orviwan/bigdub/cad/official_pebble_models/pebble_classic_drawing-1.png

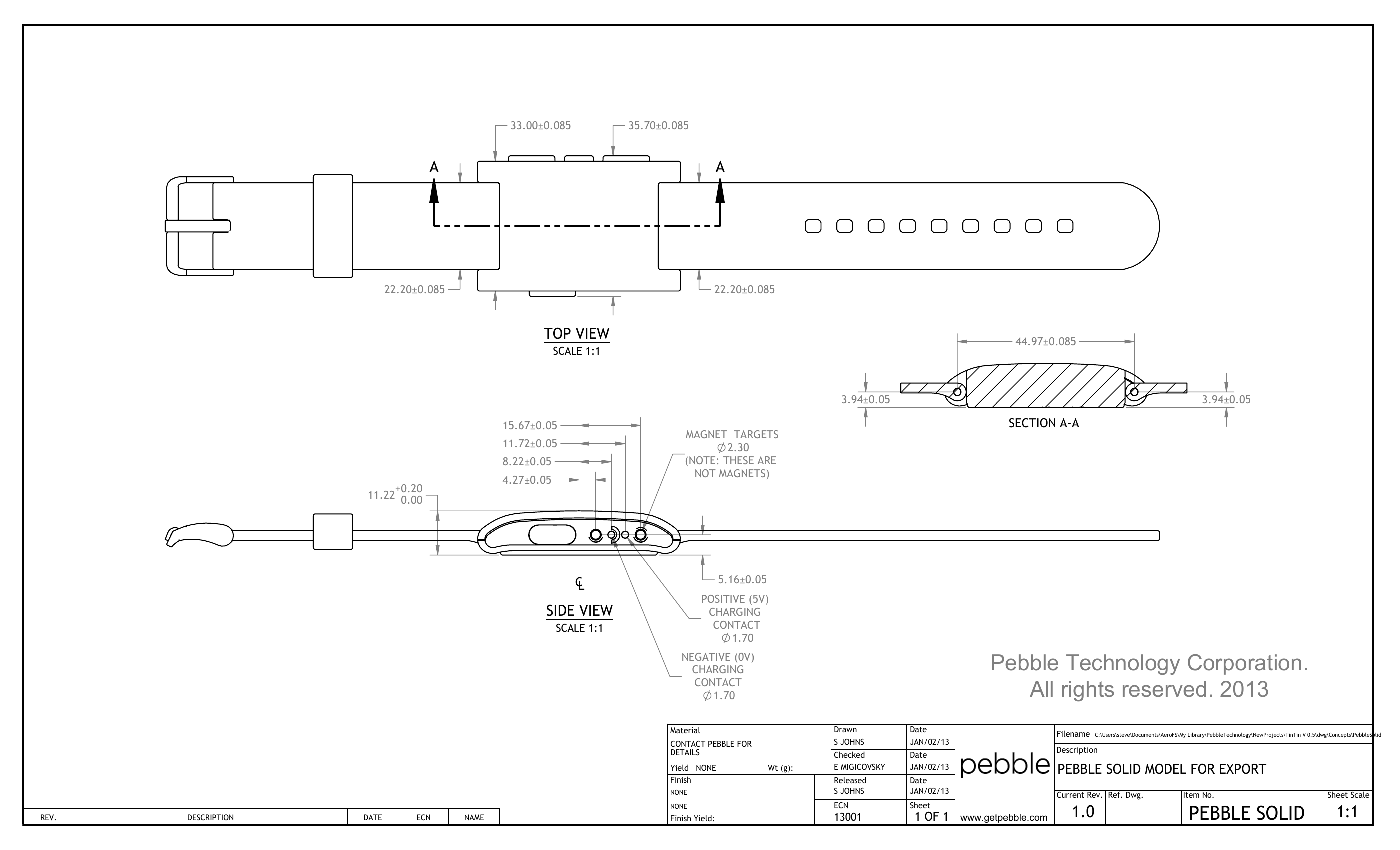
cad/official_pebble_models/pebble_classic_drawing-1.png
