orviwan/bigdub/cad/pebble_screen_texture.png

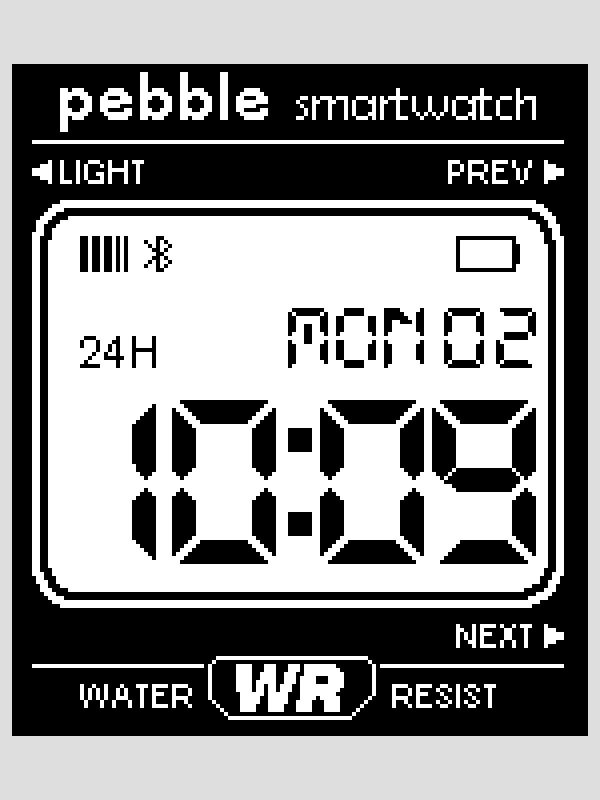
cad/pebble_screen_texture.png
