orviwan/bigdub/cad/textures/91dub_nook_screen.png

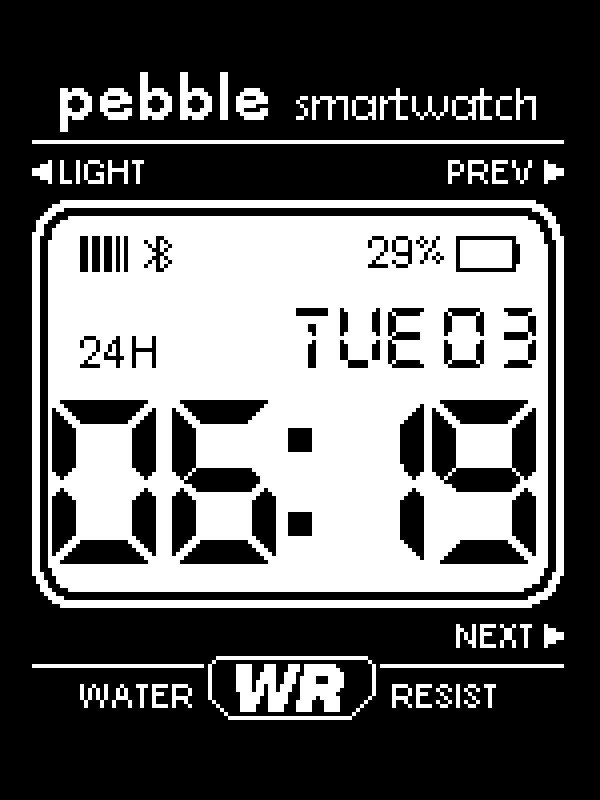
cad/textures/91dub_nook_screen.png
