orviwan/bigdub/cad/stls/pebble_clock_full_assembly.stl

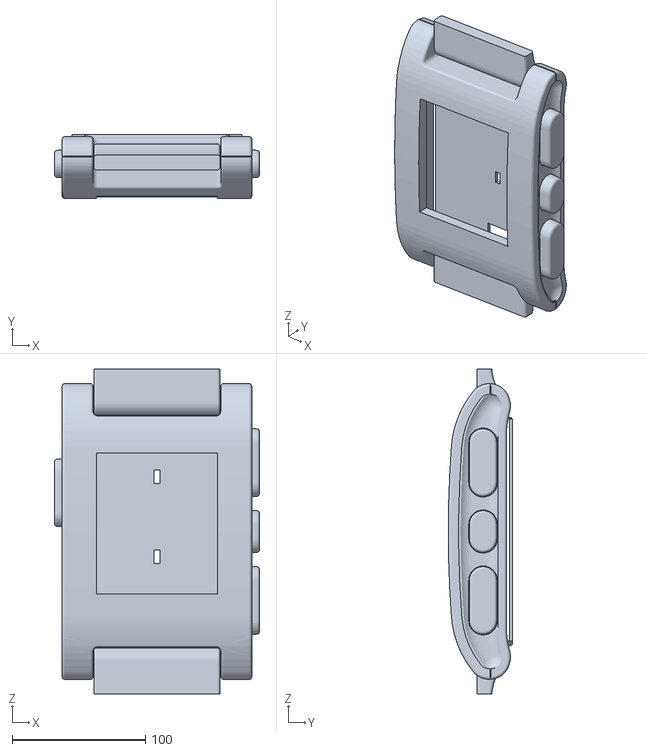
[picture p6: CAD file, 2026-11-07]
cad/stls/pebble_clock_full_assembly.stl
154.0 x 48.4 x 244.0
