orviwan/bigdub/cad/stls/pebble_classic_clock_full_assembly.stl

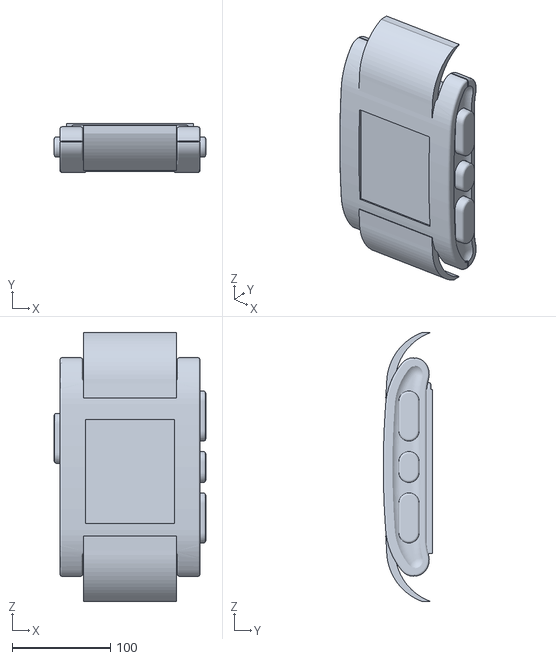
[picture p7: CAD file, 2026-11-07]
cad/stls/pebble_classic_clock_full_assembly.stl
154.0 x 50.2 x 273.4
