orviwan/bigdub/cad/official_pebble_models/pebble_2_3d.stl

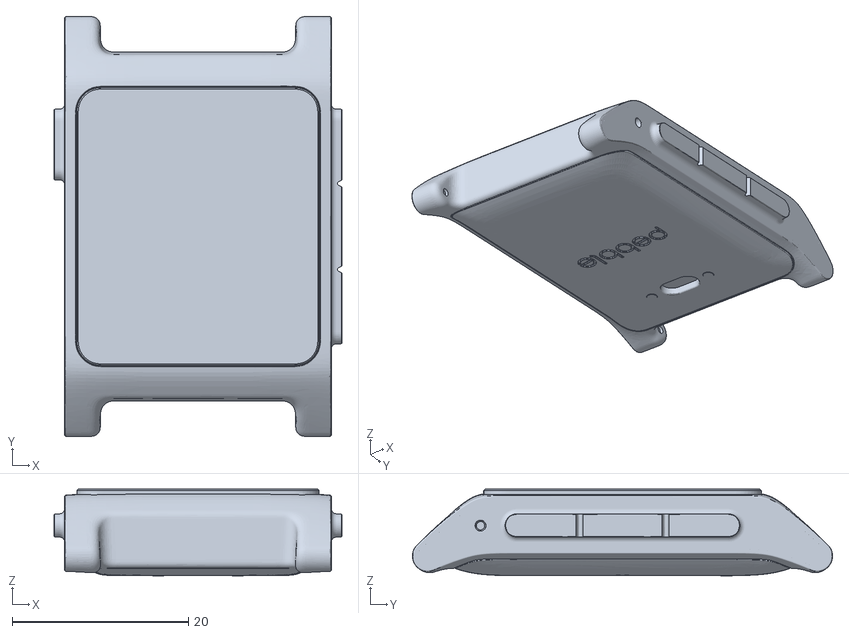
[picture p8: CAD file, 2026-11-07]
cad/official_pebble_models/pebble_2_3d.stl
32.7 x 47.6 x 9.85
