orviwan/bigdub/cad/stls/pebble_classic_strap_bottom.stl

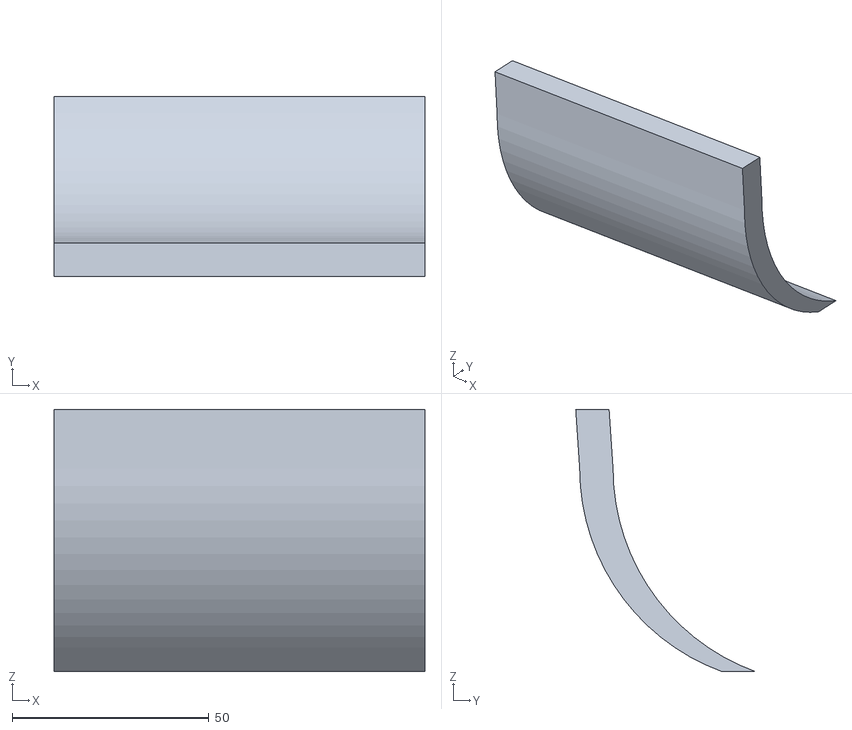
[picture p9: CAD file, 2026-11-07]
cad/stls/pebble_classic_strap_bottom.stl
94.4 x 45.7 x 66.7
