orviwan/bigdub/cad/official_pebble_models/pebble_time_steel.stl

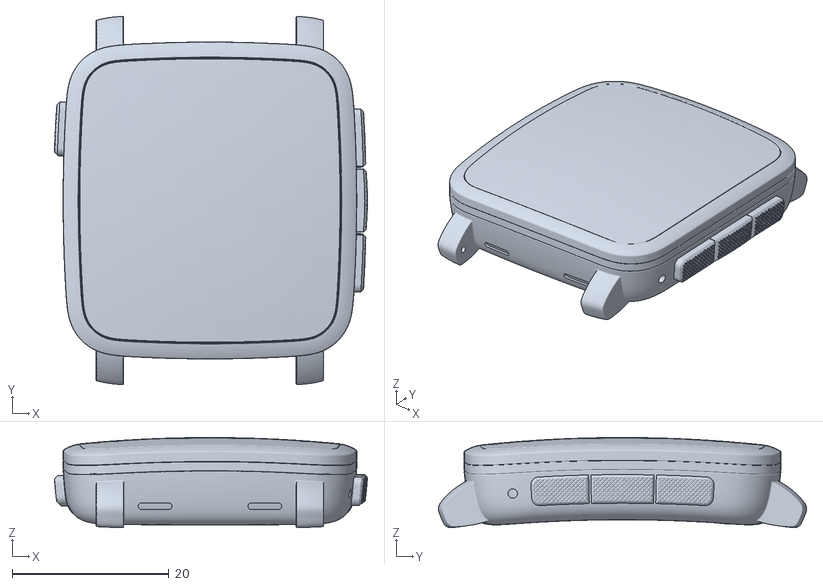
[picture p10: CAD file, 2026-11-07]
cad/official_pebble_models/pebble_time_steel.stl
39.9 x 46.9 x 11.5
