orviwan/bigdub/cad/official_pebble_models/pebble_2_duo_solid.stl

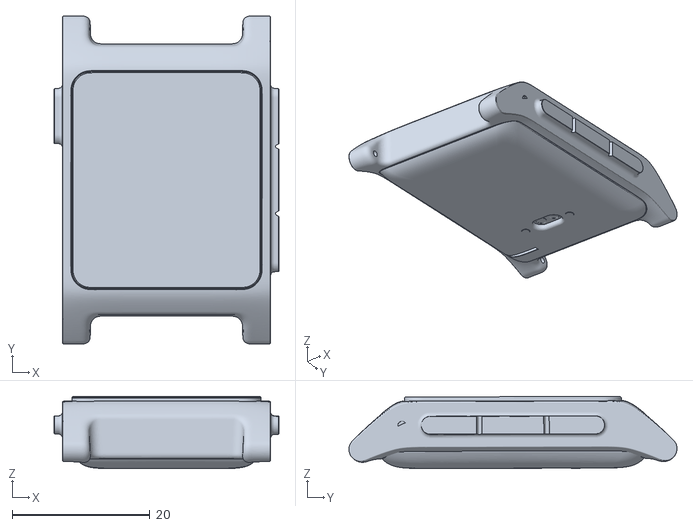
[picture p11: CAD file, 2026-11-07]
cad/official_pebble_models/pebble_2_duo_solid.stl
32.6 x 47.6 x 10.5
