orviwan/bigdub/cad/stls/pebble_clock_back_cover.stl

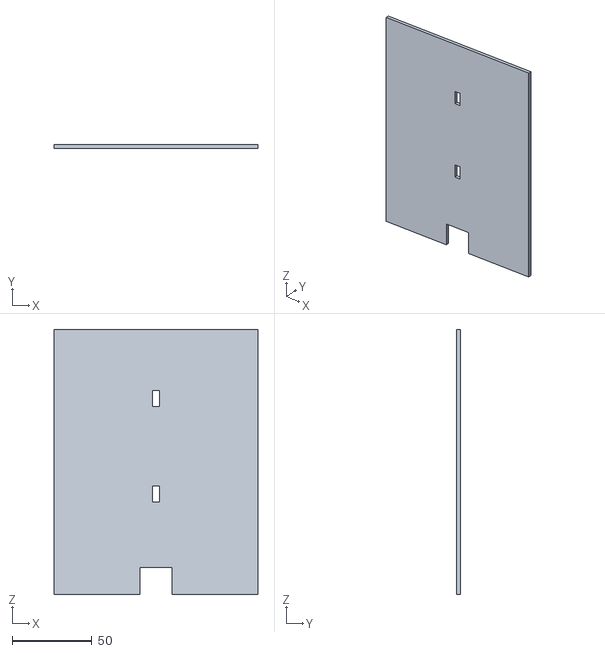
[picture p12: CAD file, 2026-11-07]
cad/stls/pebble_clock_back_cover.stl
128.0 x 2.50 x 166.5
