orviwan/bigdub/cad/official_pebble_models/pebble_time_exterior.stl

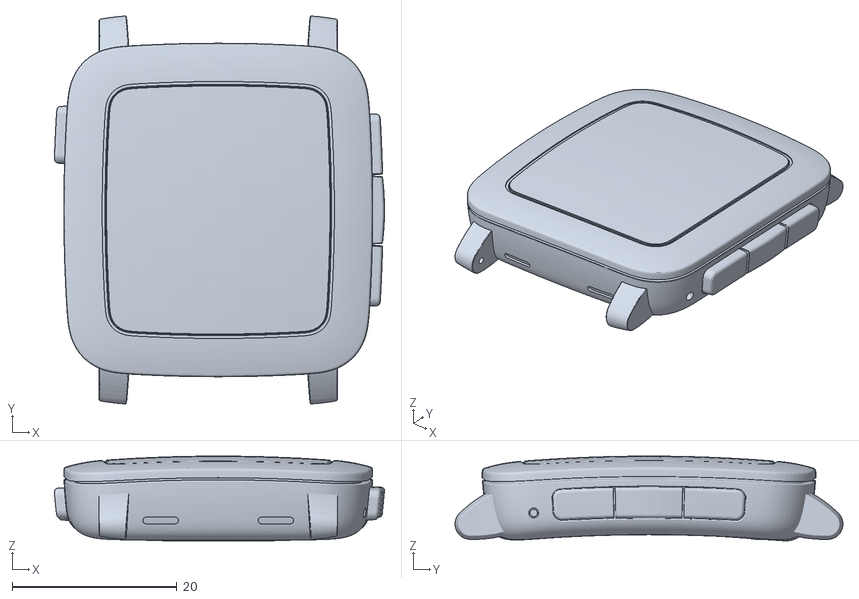
[picture p13: CAD file, 2026-11-07]
cad/official_pebble_models/pebble_time_exterior.stl
40.1 x 47.1 x 10.3
