orviwan/bigdub/cad/stls/pebble_classic_clock_body.stl

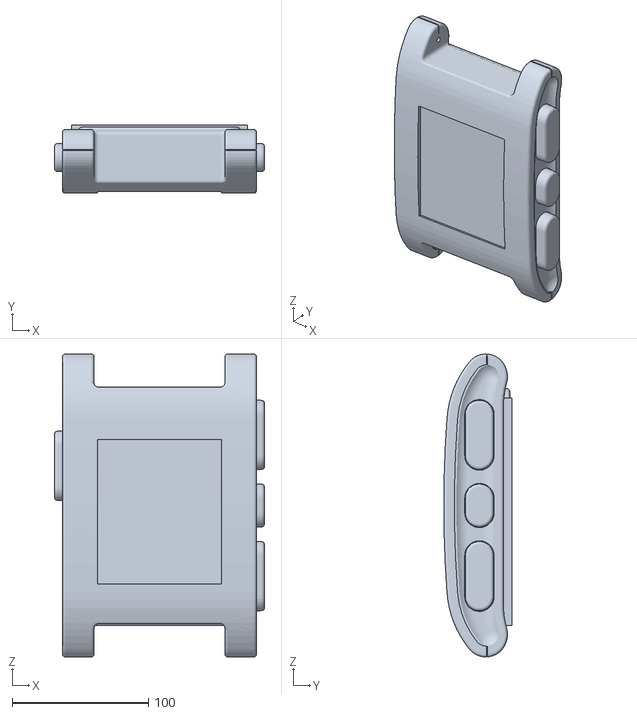
[picture p14: CAD file, 2026-11-07]
cad/stls/pebble_classic_clock_body.stl
154.0 x 50.2 x 222.1
