orviwan/bigdub/cad/official_pebble_models/PebbleSolid-20130102.STEP

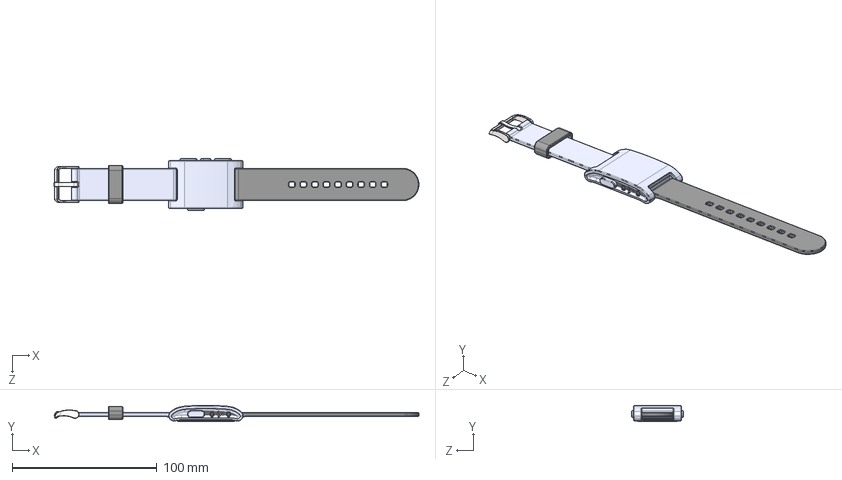
[picture p15: CAD file, 2026-11-07]
cad/official_pebble_models/PebbleSolid-20130102.STEP
252.6 x 11.2 x 35.7 mm
