orviwan/bigdub/cad/stls/pebble_classic_body_1x.stl

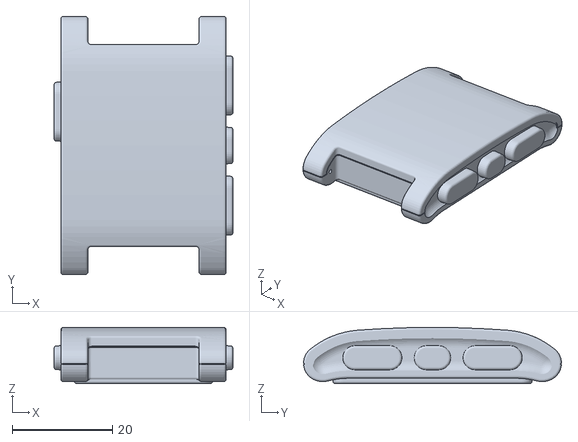
[picture p16: CAD file, 2026-11-07]
cad/stls/pebble_classic_body_1x.stl
35.7 x 51.5 x 11.2
