orviwan/bigdub/cad/stls/pebble_clock_body_PRINT_READY.3mf

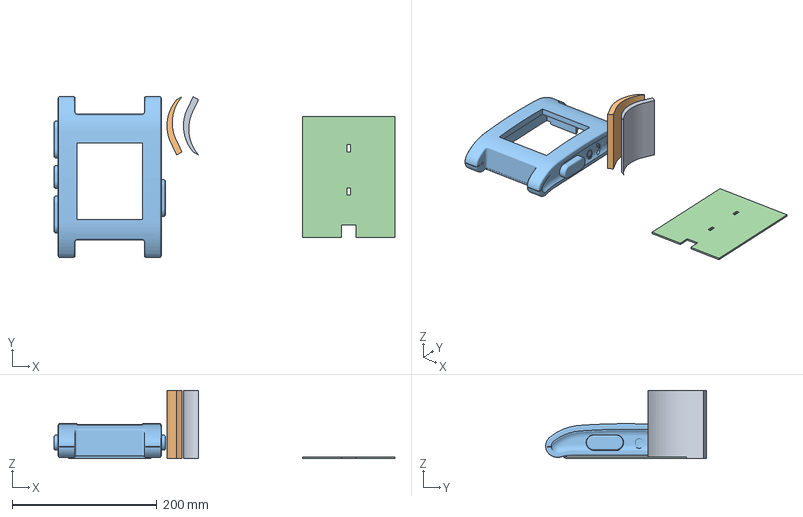
[picture p17: CAD file, 2026-11-07]
cad/stls/pebble_clock_body_PRINT_READY.3mf
471.0 x 222.1 x 94.4 mm
pebble_classic_strap_bottom.stl
pebble_classic_strap_top.stl
pebble_clock_body_PRINT_READY.stl
pebble_clock_back_cover_PRINT_READY.stl
