orviwan/bigdub/cad/stls/pebble_clock_strap_bottom.stl

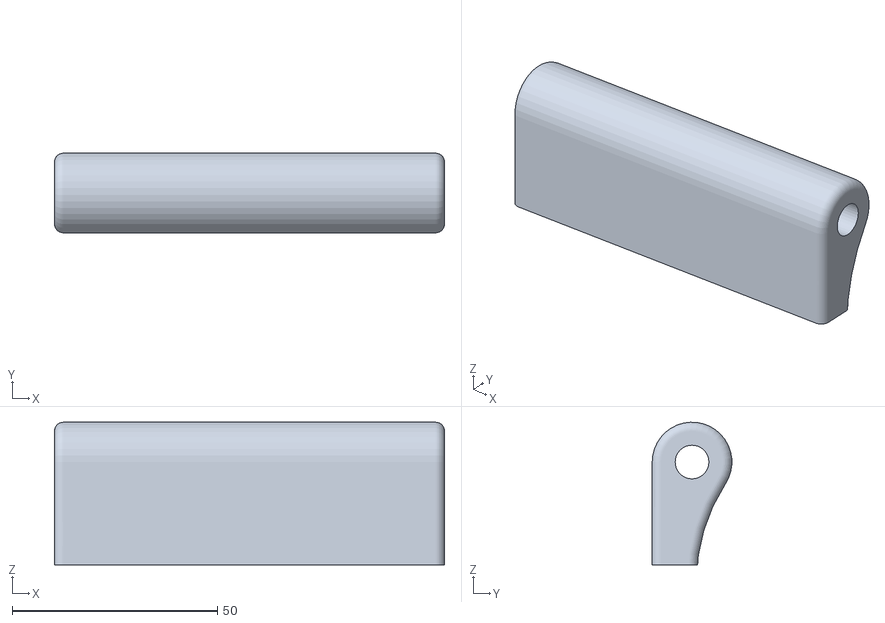
[picture p18: CAD file, 2026-11-07]
cad/stls/pebble_clock_strap_bottom.stl
94.9 x 19.4 x 34.7
