orviwan/bigdub/cad/stls/pebble_clock_body.stl

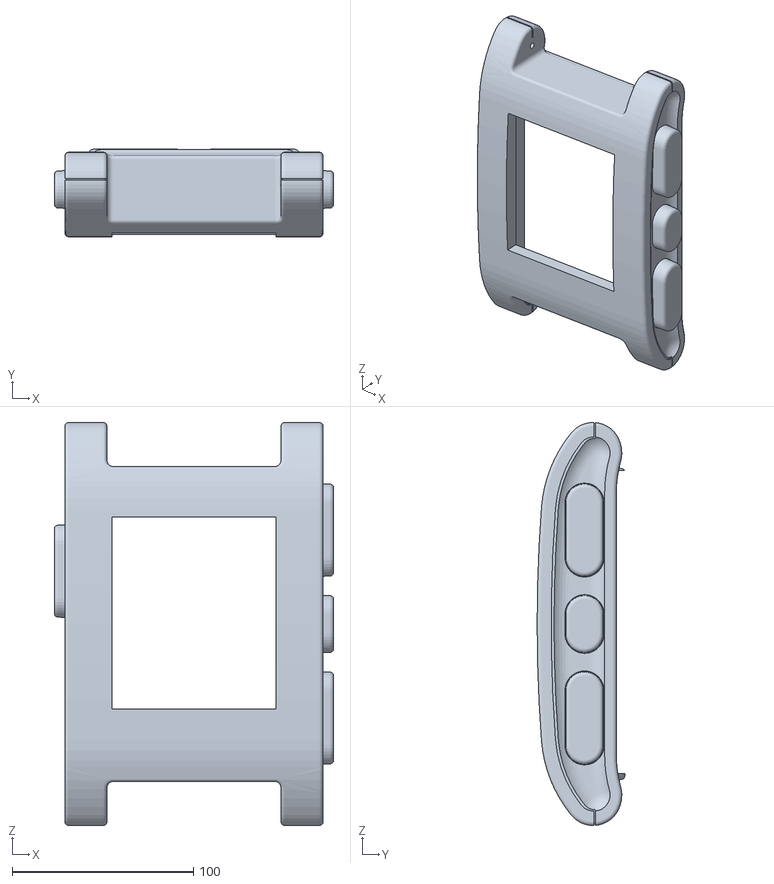
[picture p19: CAD file, 2026-11-07]
cad/stls/pebble_clock_body.stl
154.0 x 48.4 x 222.1
