orviwan/bigdub/cad/stls/giant_pebble_classic_wall_clock.stl

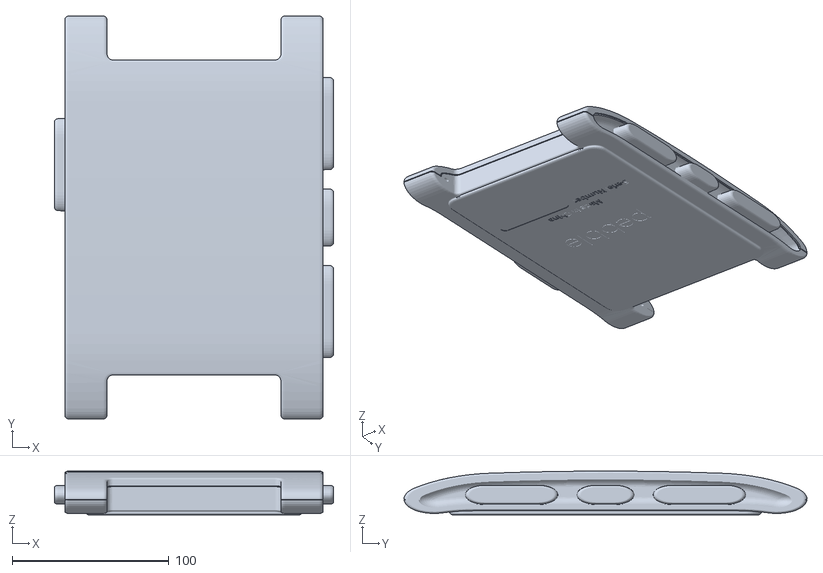
[picture p20: CAD file, 2026-11-07]
cad/stls/giant_pebble_classic_wall_clock.stl
178.5 x 257.4 x 28.0
