orviwan/bigdub/cad/stls/pebble_clock_rear_mount.stl

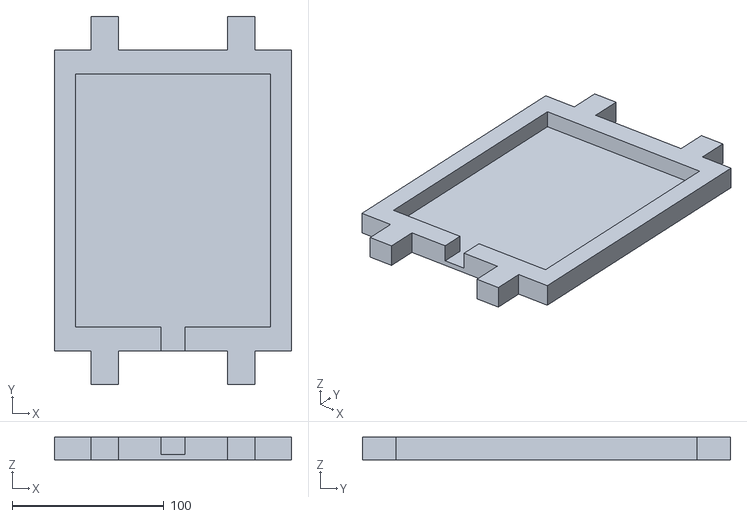
[picture p21: CAD file, 2026-11-02]
cad/stls/pebble_clock_rear_mount.stl
156.2 x 242.2 x 15.0
