orviwan/bigdub/cad/stls/pebble_clock_button_caps.stl

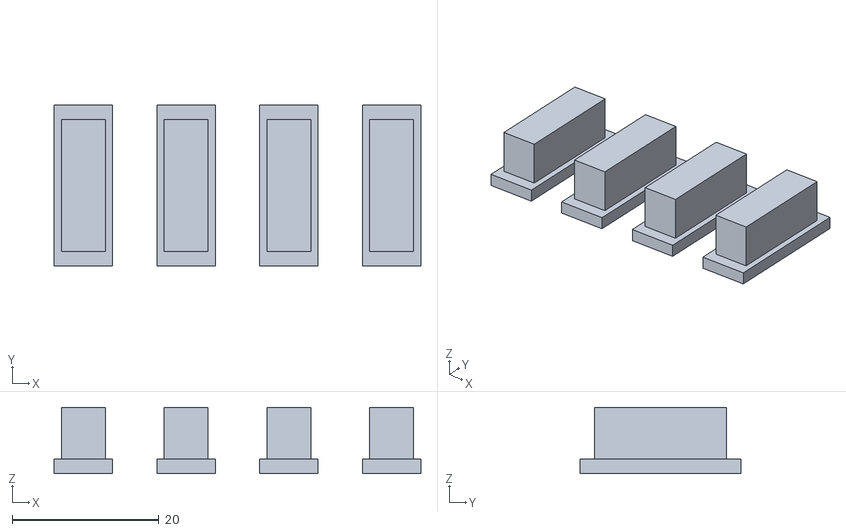
[picture p22: CAD file, 2026-11-02]
cad/stls/pebble_clock_button_caps.stl
50.0 x 22.0 x 9.00
