orviwan/bigdub/cad/stls/pebble_clock_front_bezel.stl

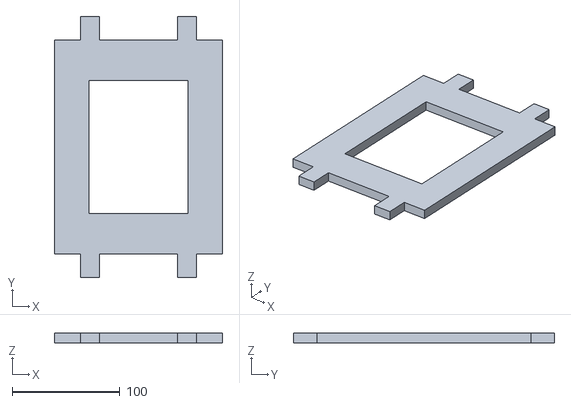
[picture p23: CAD file, 2026-11-02]
cad/stls/pebble_clock_front_bezel.stl
156.2 x 242.2 x 9.00
