orviwan/bigdub/cad/stls/pebble_clock_desk_stand.stl

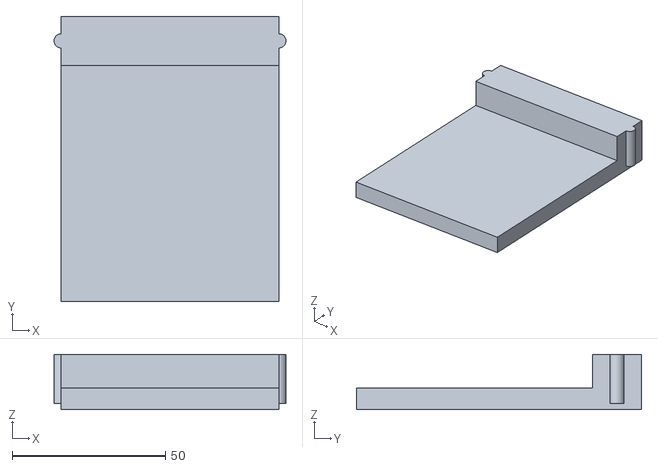
[picture p24: CAD file, 2026-11-02]
cad/stls/pebble_clock_desk_stand.stl
75.6 x 93.0 x 18.0
