orviwan/bigdub/(list of files, cad)

Other CAD files:
cad/stls/pebble_classic_strap_top.stl
cad/stls/pebble_clock_strap_top.stl
cad/stls/pebble_clock_back_cover_PRINT_READY.stl
cad/giant_pebble_wall_clock.blend
cad/official_pebble_models.blend
cad/official_pebble_models/PebbleSolid-20130102.IGS
cad/official_pebble_models/PebbleSolid-20130102.STL
cad/pebble_classic_wall_clock.blend
cad/pebble_wall_clock.blend
cad/stls/pebble_clock_body_PRINT_READY.stl
