orviwan/bigdub/(commit log)

2026-11-02 Initial commit: Pebble 91Dub giant wall clock CAD, E-Ink dashboard, and Nook setup
    [pebble_clock_button_caps.stl, pebble_clock_desk_stand.stl, pebble_clock_front_bezel.stl, pebble_clock_rear_mount.stl, pebble_wall_clock.scad]
2026-11-07 Add production Pebble wall clock CAD, 3D printing guide, watchface conversion docs, and dual licensing
    [PebbleSolid-20130102.IGS, PebbleSolid-20130102.STEP, PebbleSolid-20130102.STL, giant_pebble_classic_wall_clock.stl, giant_pebble_wall_clock.blend, official_pebble_models.blend, pebble_2_3d.stl, pebble_2_duo_solid.stl]
2026-11-07 feat(clock): set default battery to 90% and add query parameter support
2026-11-07 feat(clock): implement day countdown battery mode, fix battery bar z-index, update ADB docs and add AGENTS.md
2026-11-07 cad: tune screen aperture to 90.2x121.8mm to mask E-Ink glass margin; document border physics in AGENTS.md
    [pebble_wall_clock.scad]
2026-11-07 docs: replace CAD render with photo of assembled 3D-printed clock alongside original Pebble
2026-11-07 licensing: clarify MIT license for repo root and CC BY-NC-SA 4.0 for cad/
2026-11-09 feat(clock): regenerate 4x DS-Digital-Bold sprites, fix battery icon order, and add -14px vertical offset
2026-11-12 feat(nook): add native Android 2.1 auto-boot HOME clock APK with real battery, partial redraws, and battery-saver mode
